tomelliot/macbook-mount/dfm/evidence/01_cartridge_front.png

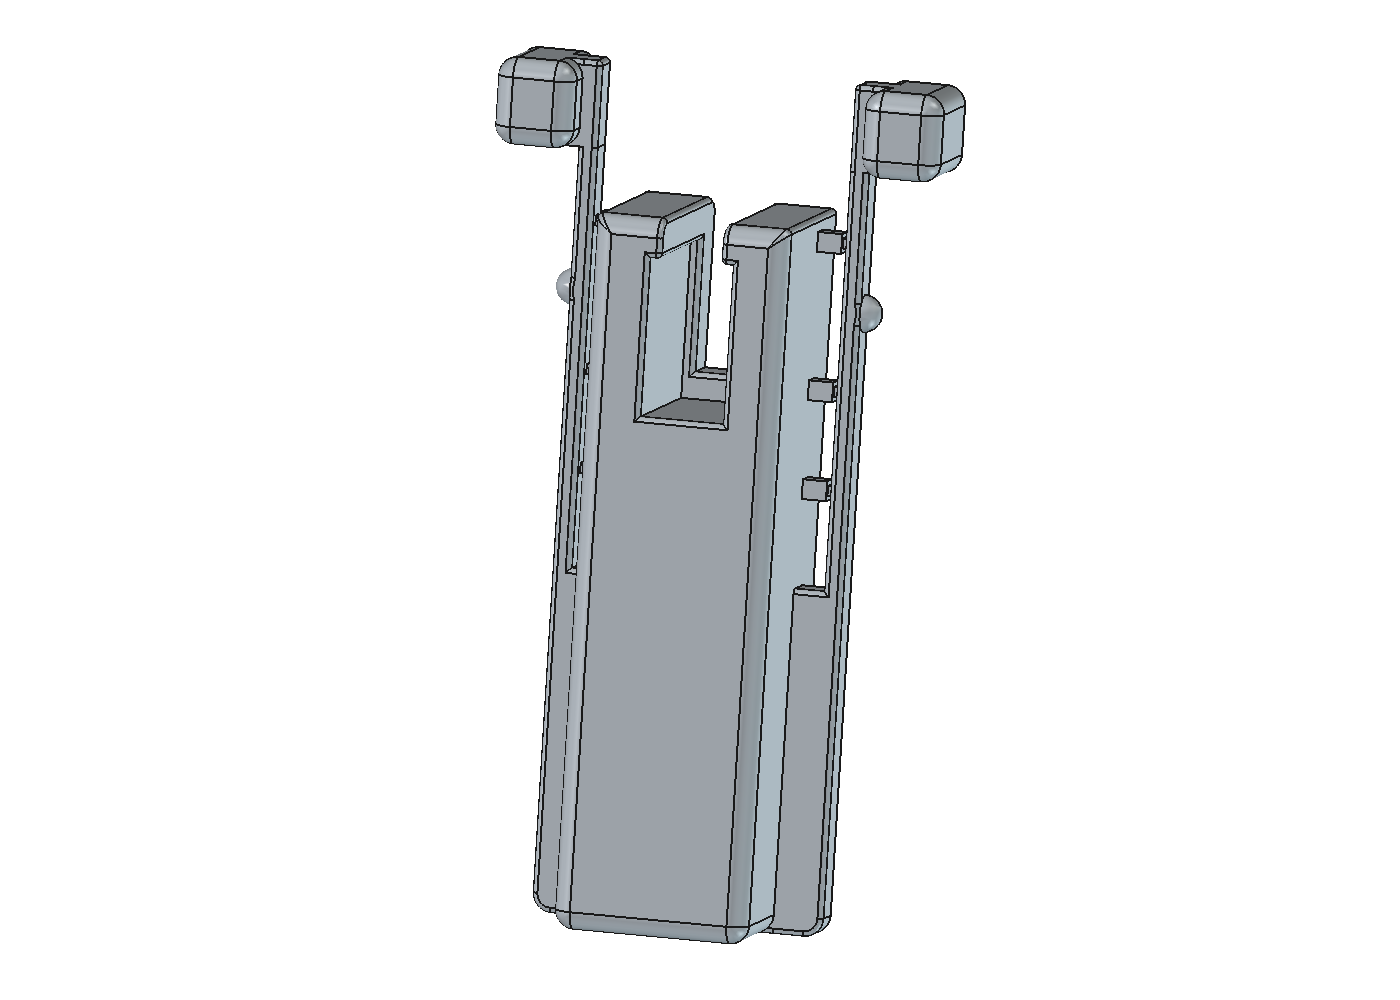
dfm/evidence/01_cartridge_front.png
