tomelliot/macbook-mount/dfm/evidence/01_cartridge_iso.png

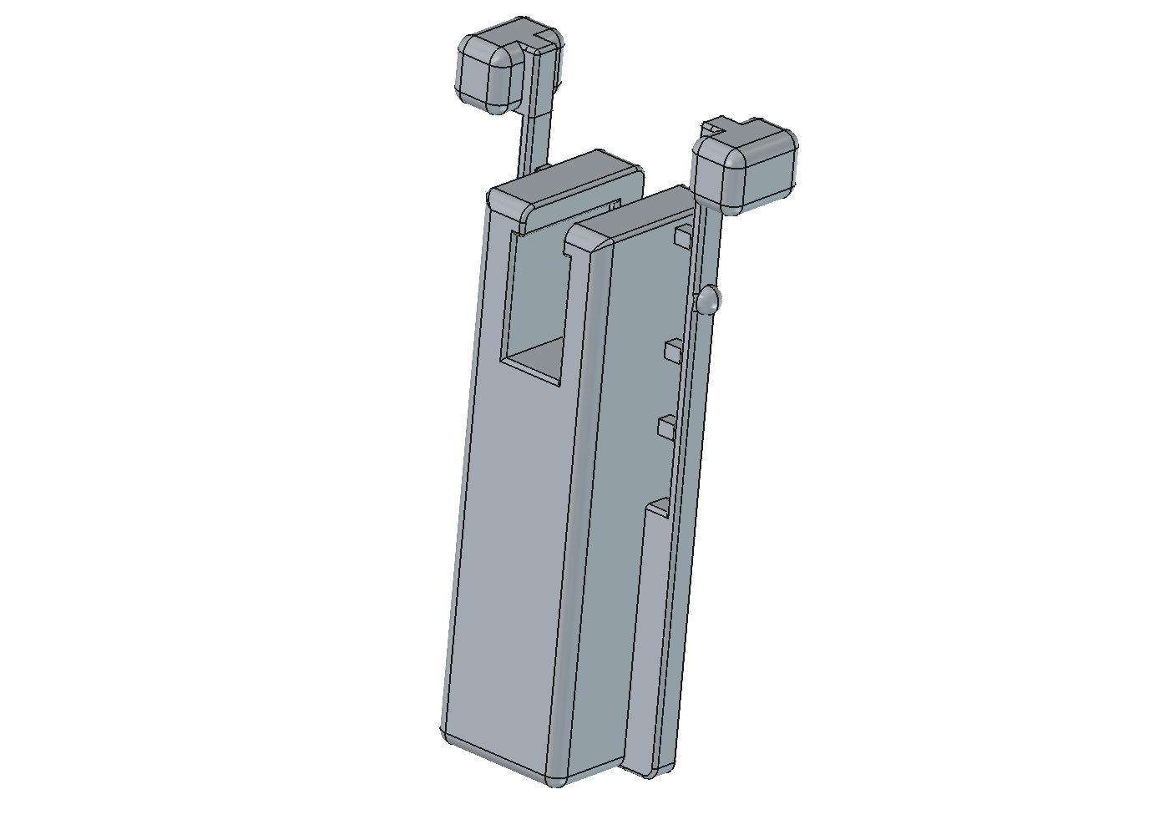
dfm/evidence/01_cartridge_iso.png
