tomelliot/macbook-mount/dfm/evidence/01_mount_back.png

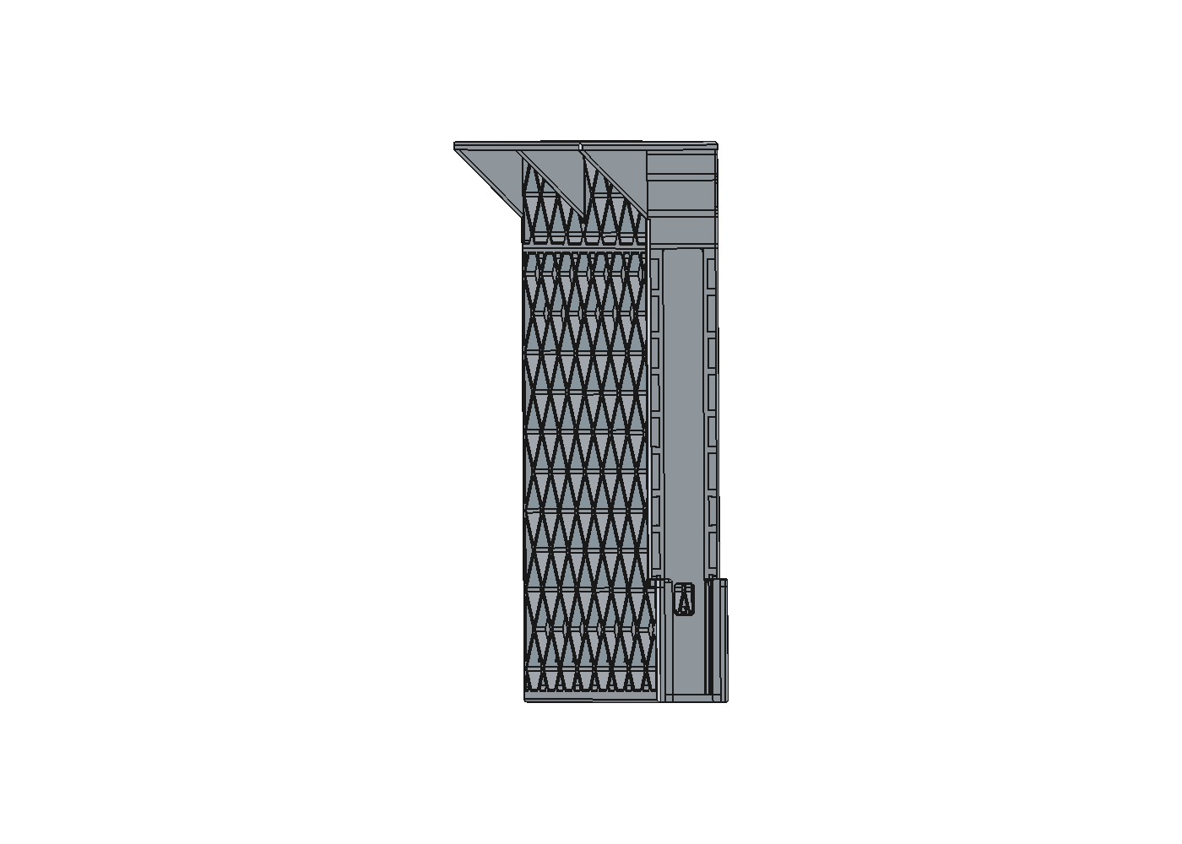
dfm/evidence/01_mount_back.png
