tomelliot/macbook-mount/dfm/evidence/01_mount_bottom.png

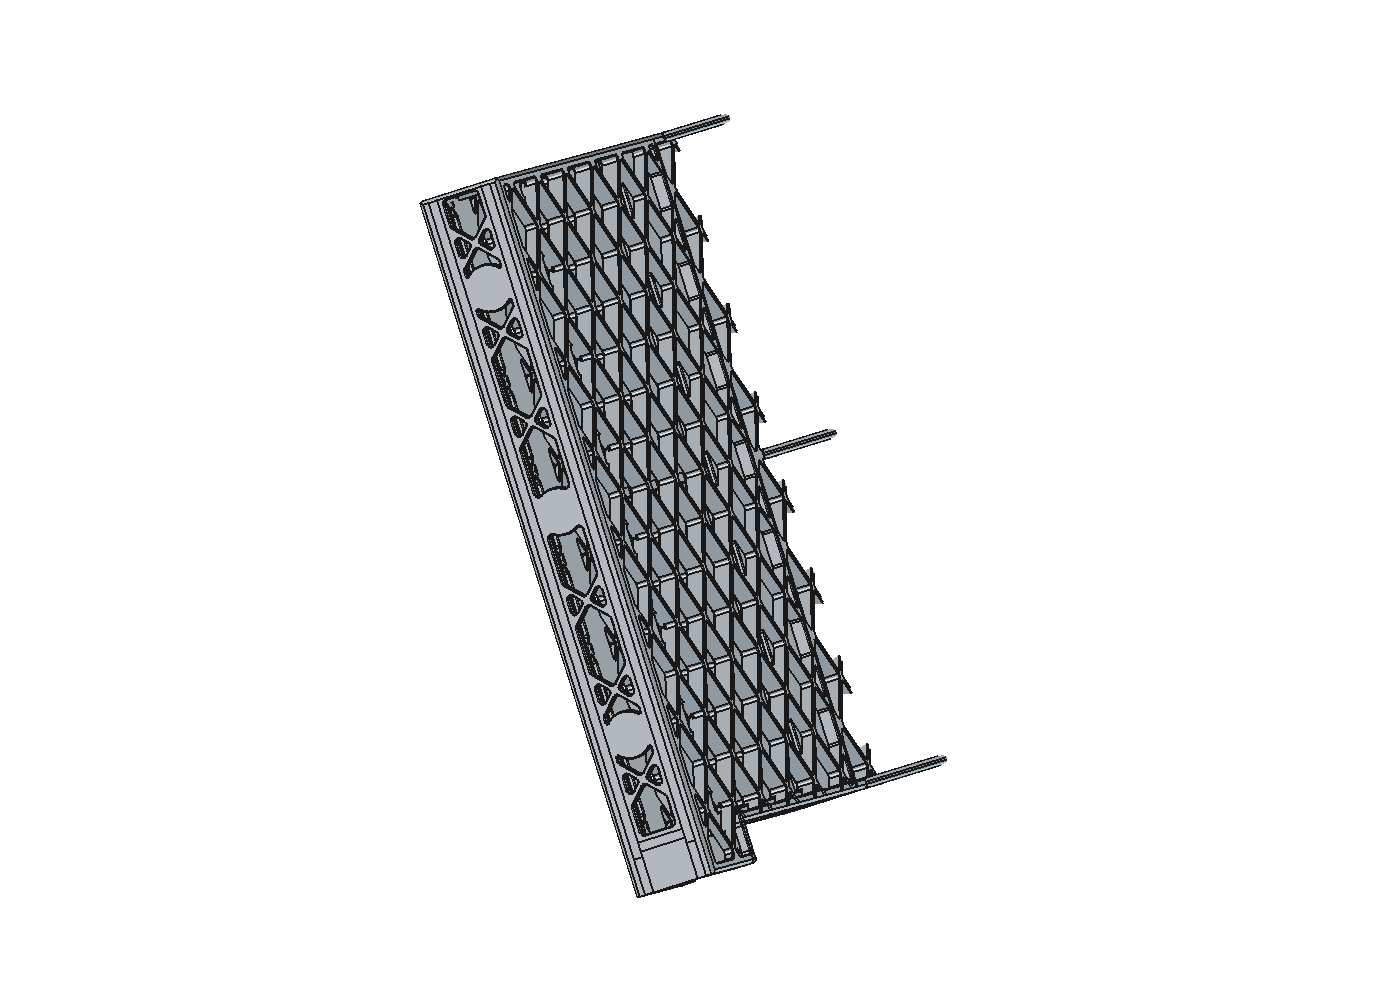
dfm/evidence/01_mount_bottom.png
