tomelliot/macbook-mount/dfm/evidence/01_mount_iso.png

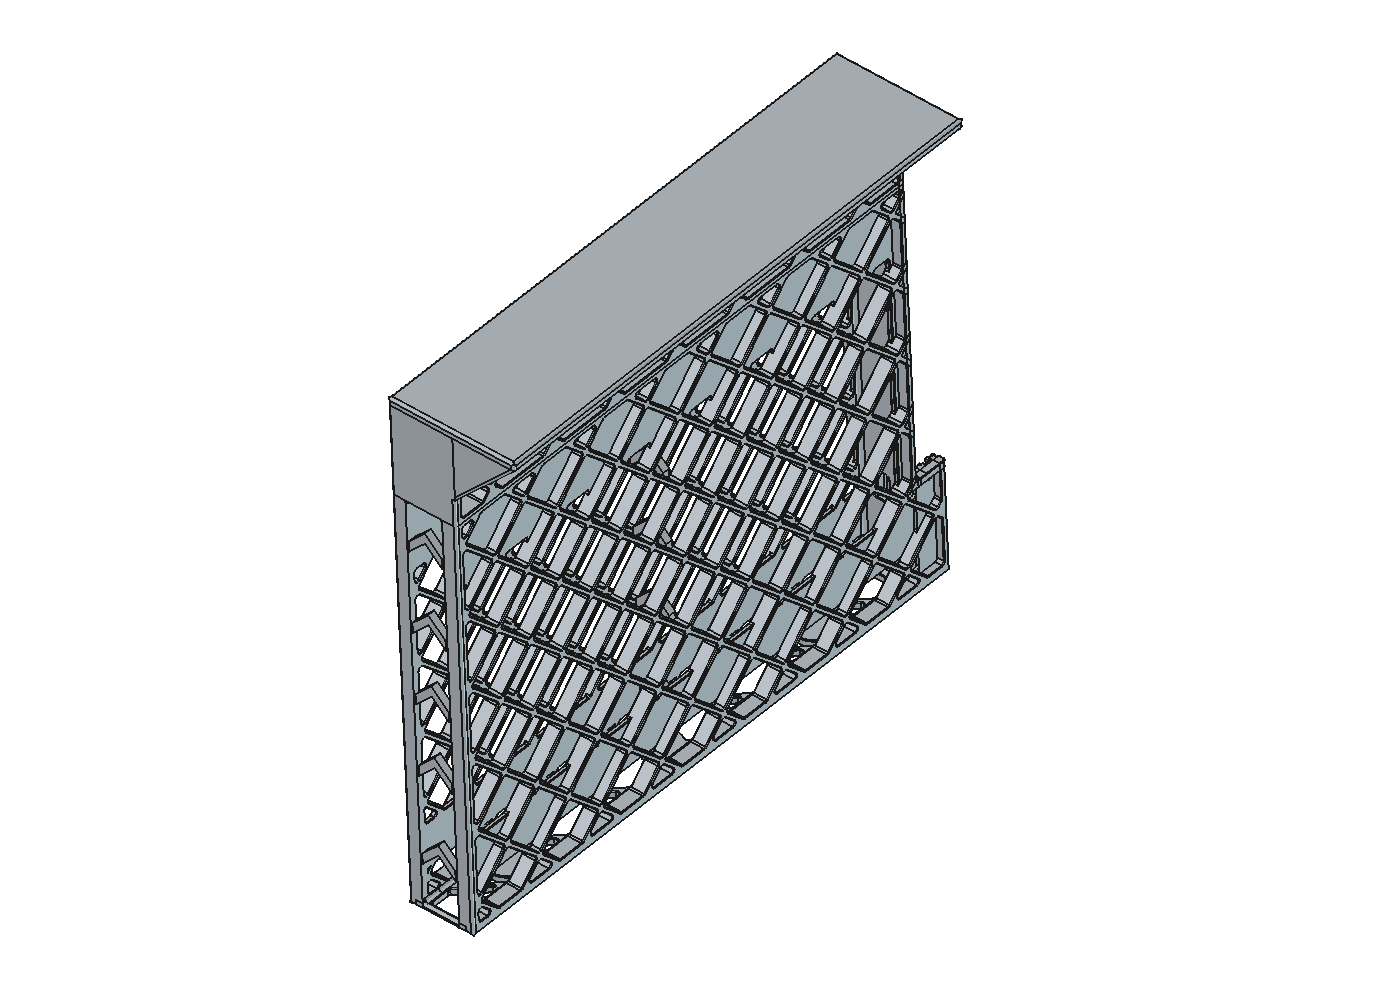
dfm/evidence/01_mount_iso.png
