tomelliot/macbook-mount/dfm/evidence/01_mount_right.png

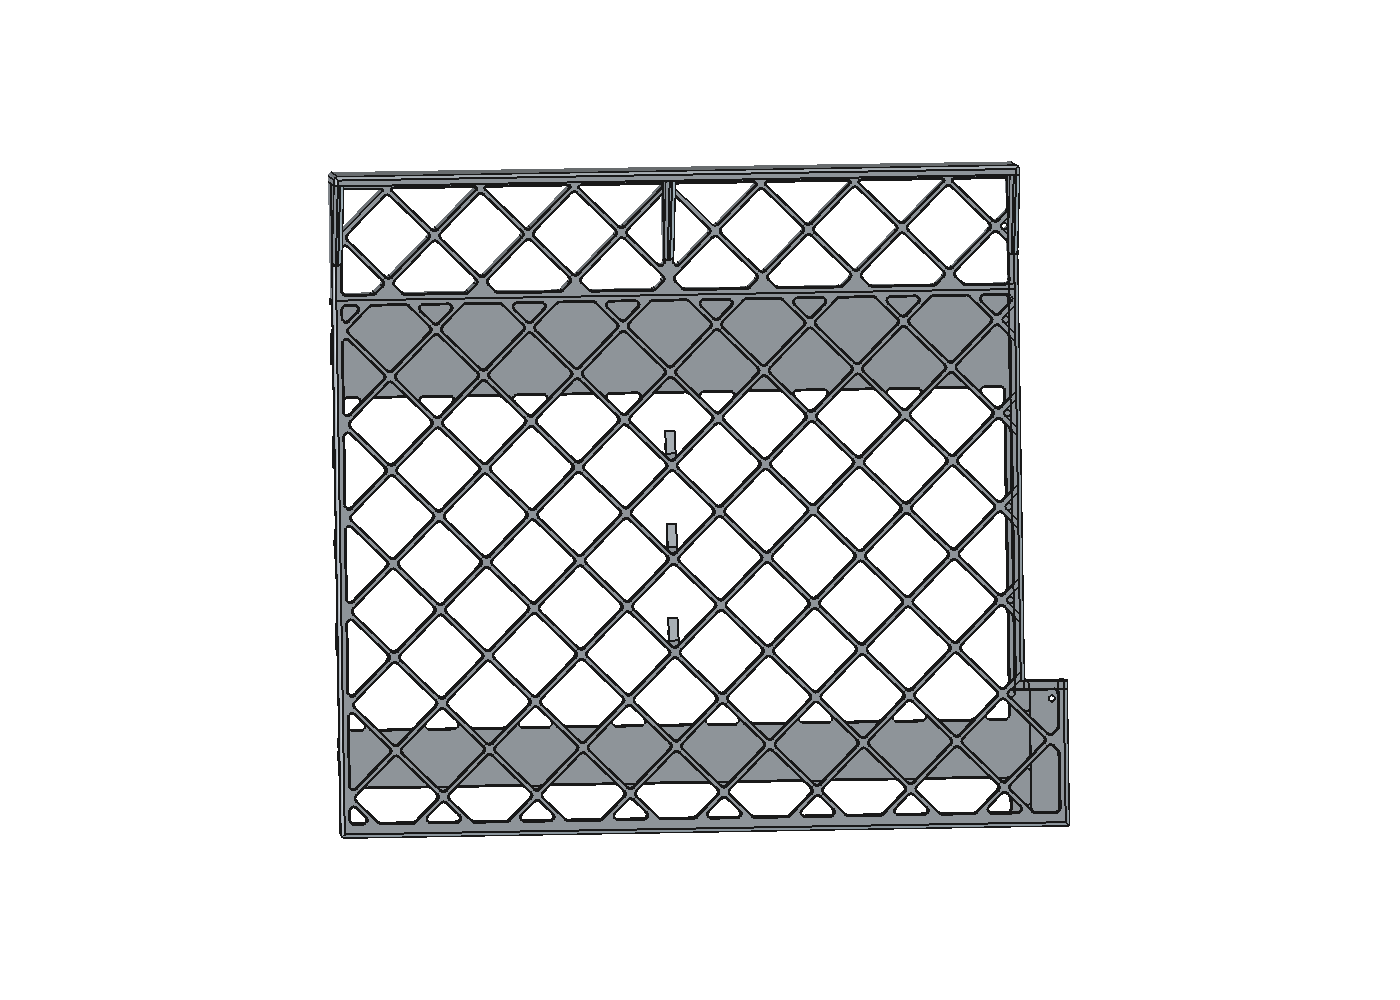
dfm/evidence/01_mount_right.png
