tomelliot/macbook-mount/dfm/evidence/02_thickness_map_cartridge.png

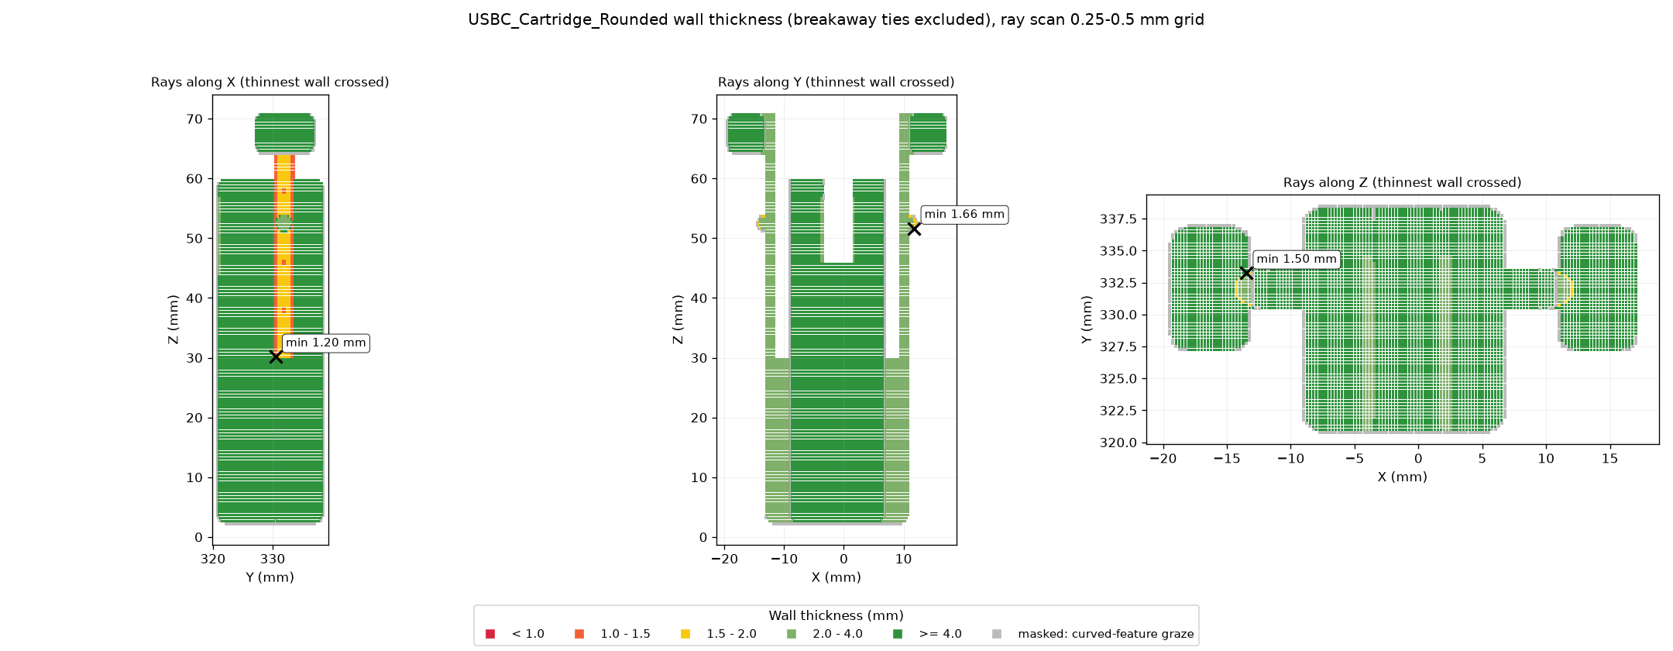
dfm/evidence/02_thickness_map_cartridge.png
