tomelliot/macbook-mount/dfm/evidence/02_thickness_map_mount.png

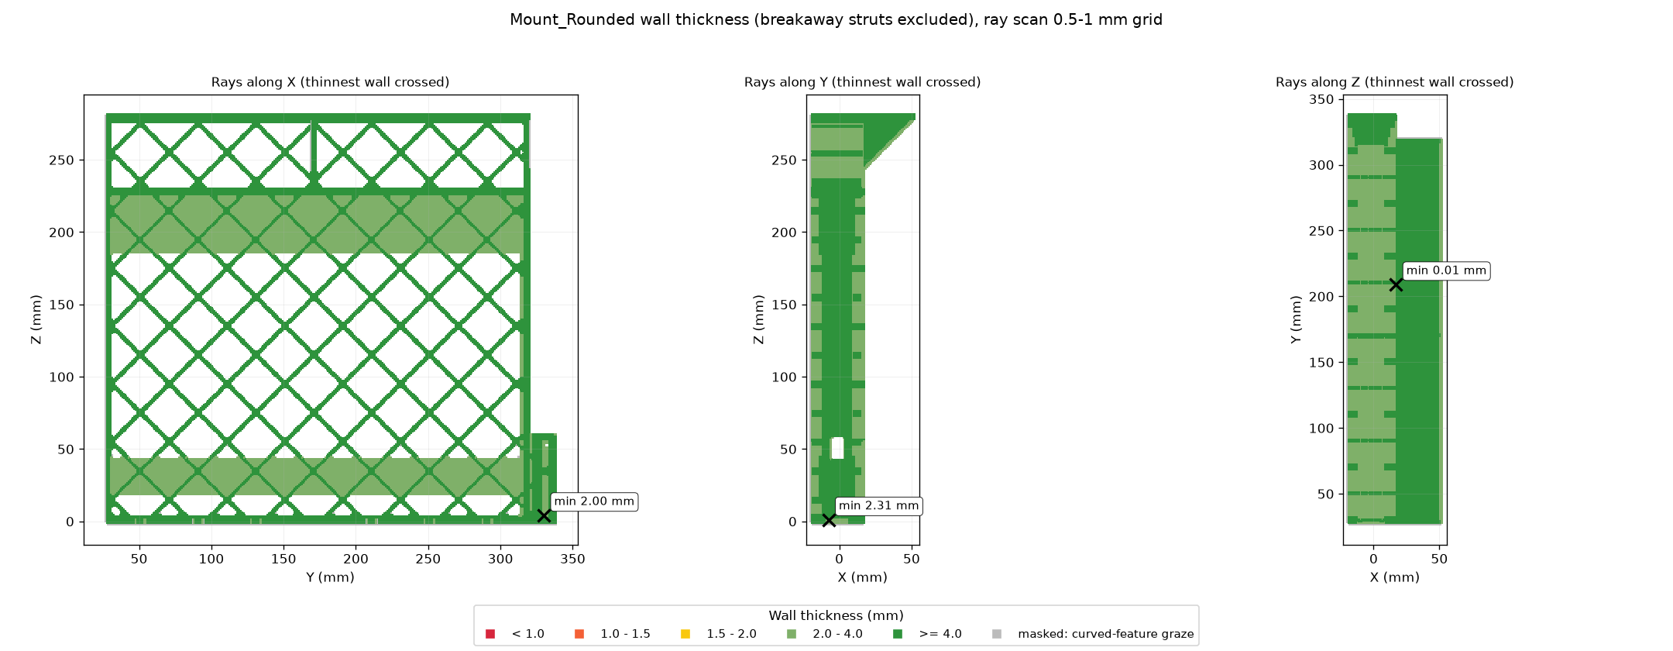
dfm/evidence/02_thickness_map_mount.png
