tomelliot/macbook-mount/dfm/evidence/05_flex_analysis.png

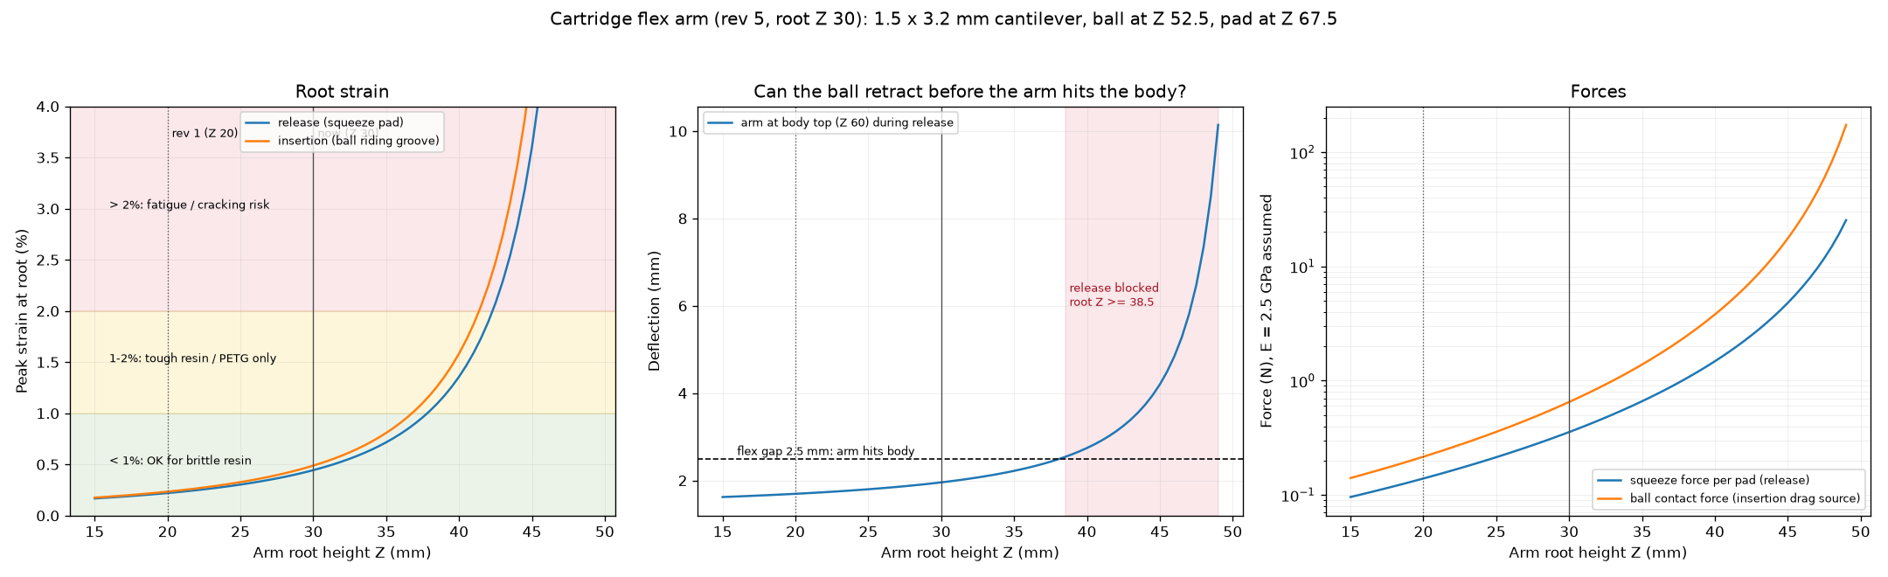
dfm/evidence/05_flex_analysis.png
