tomelliot/macbook-mount/dfm/evidence/06_clearance_bands.png

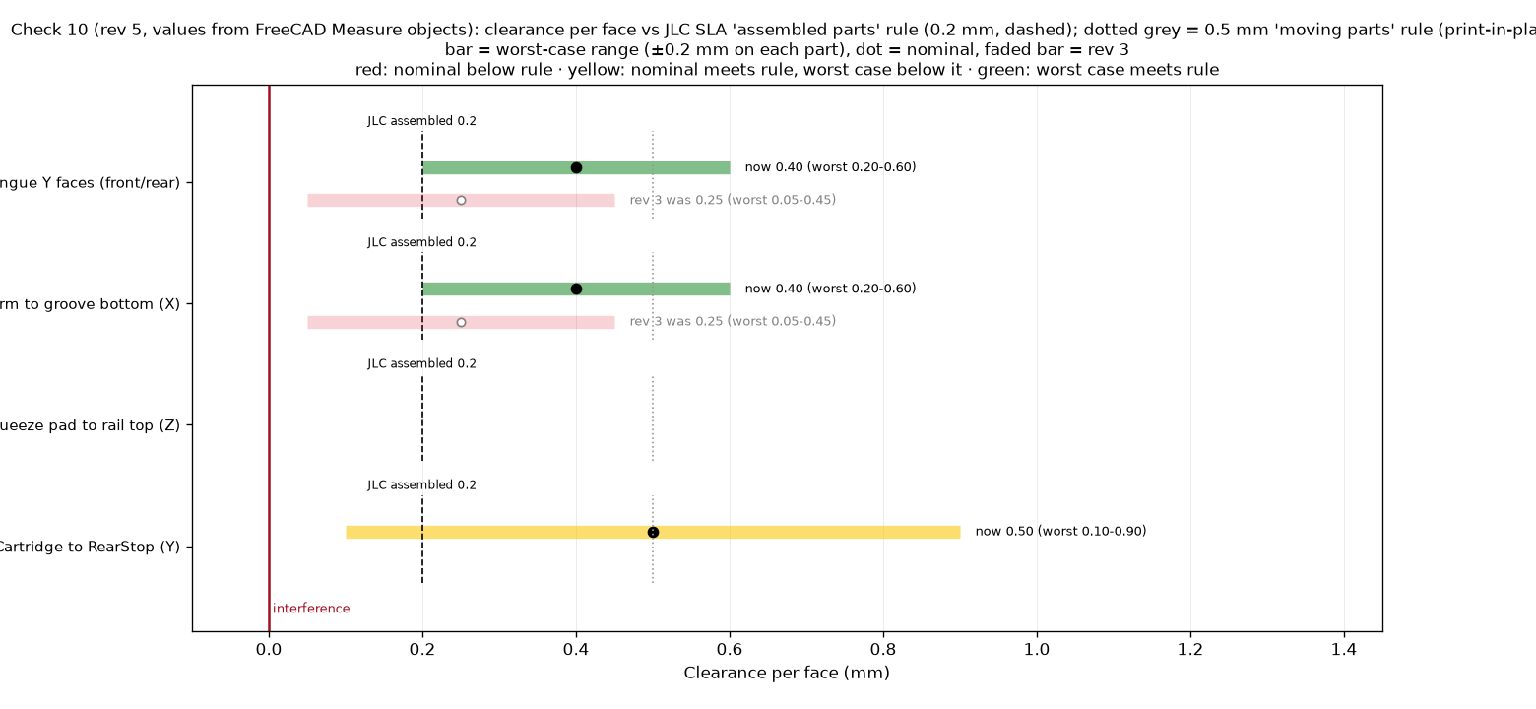
dfm/evidence/06_clearance_bands.png
