tomelliot/macbook-mount/dfm/evidence/07_breakaway_supports.png

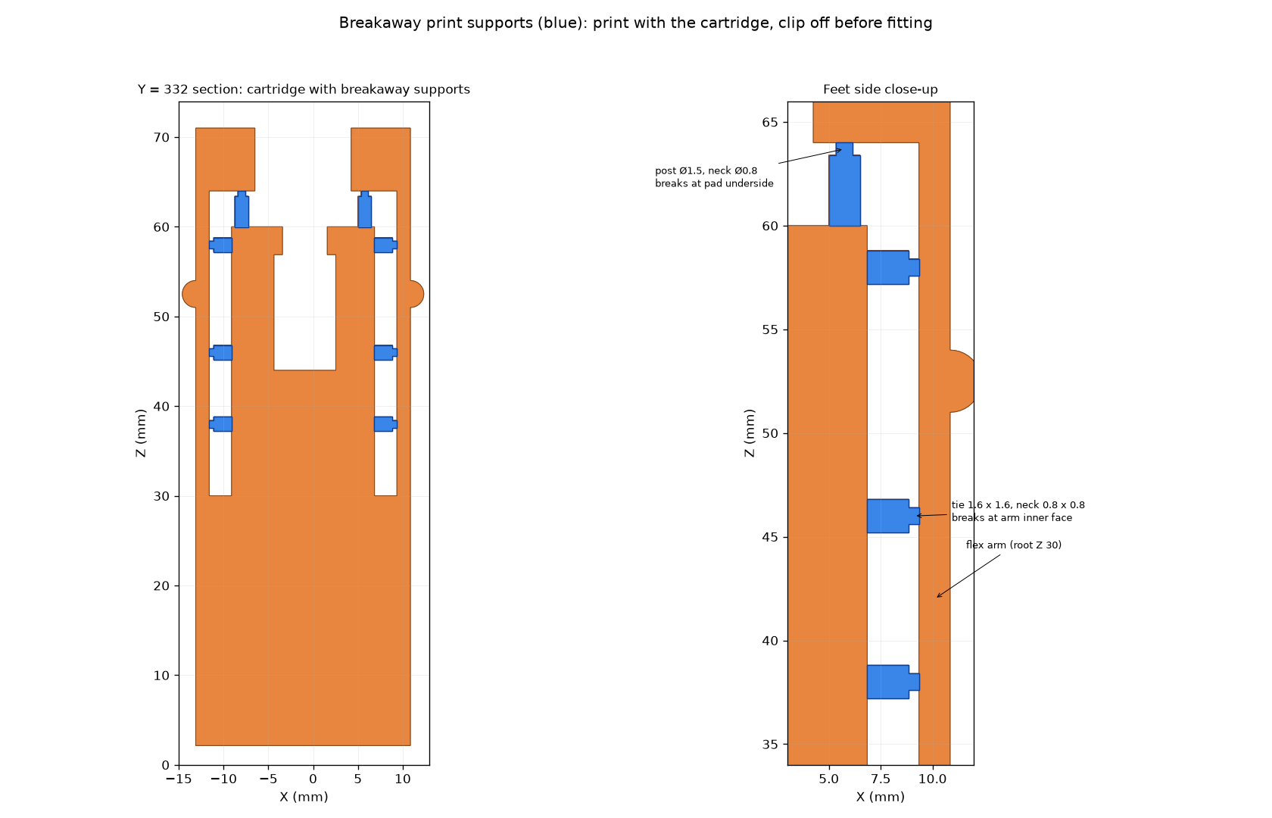
dfm/evidence/07_breakaway_supports.png
