tomelliot/macbook-mount/dfm/evidence/08_support_map.png

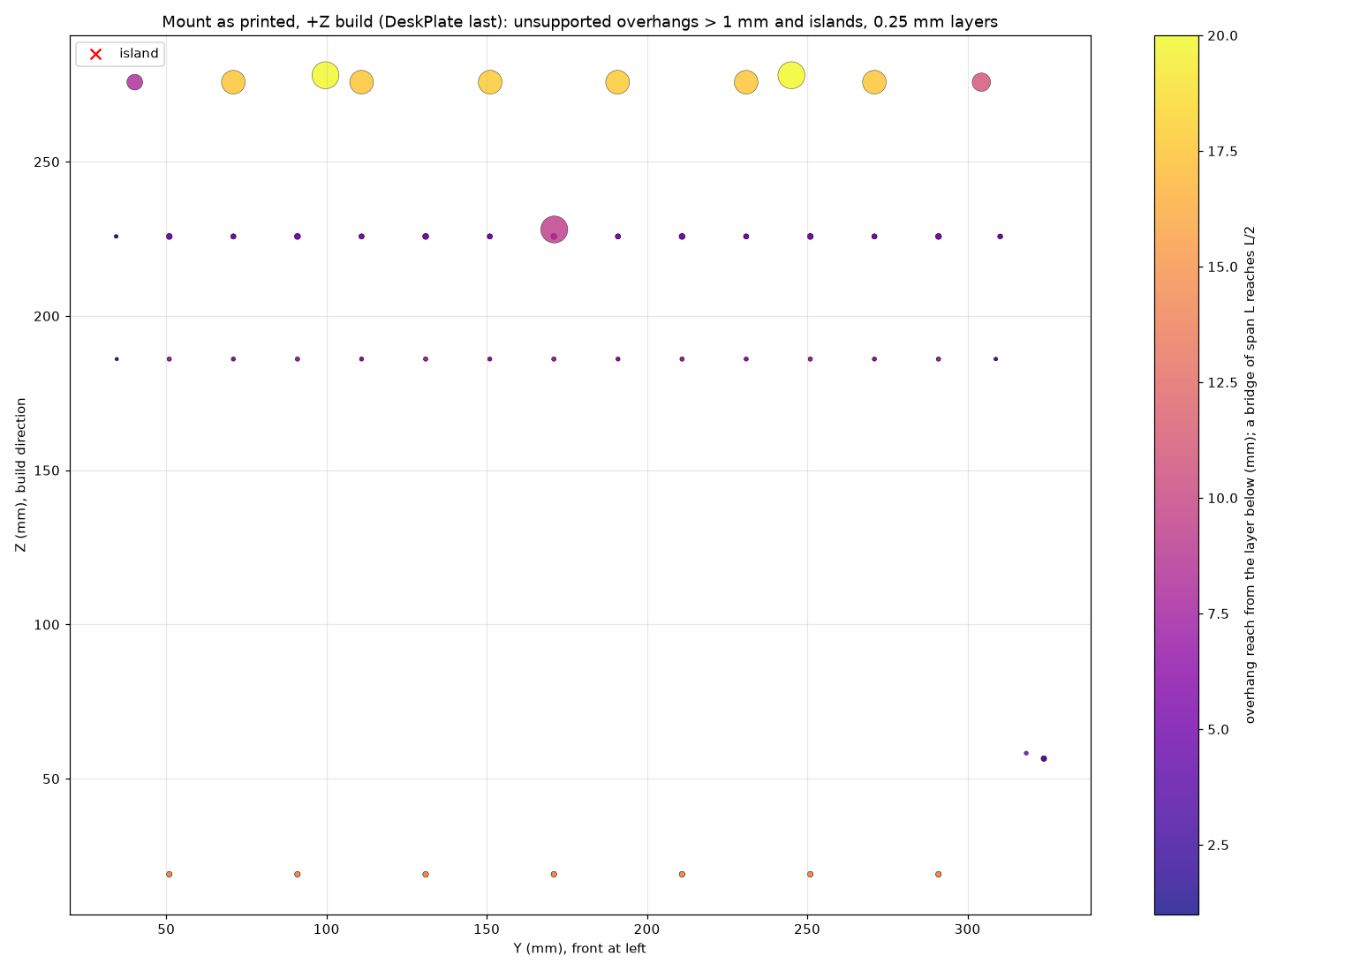
dfm/evidence/08_support_map.png
