tomelliot/macbook-mount/DeskMount.FCStd

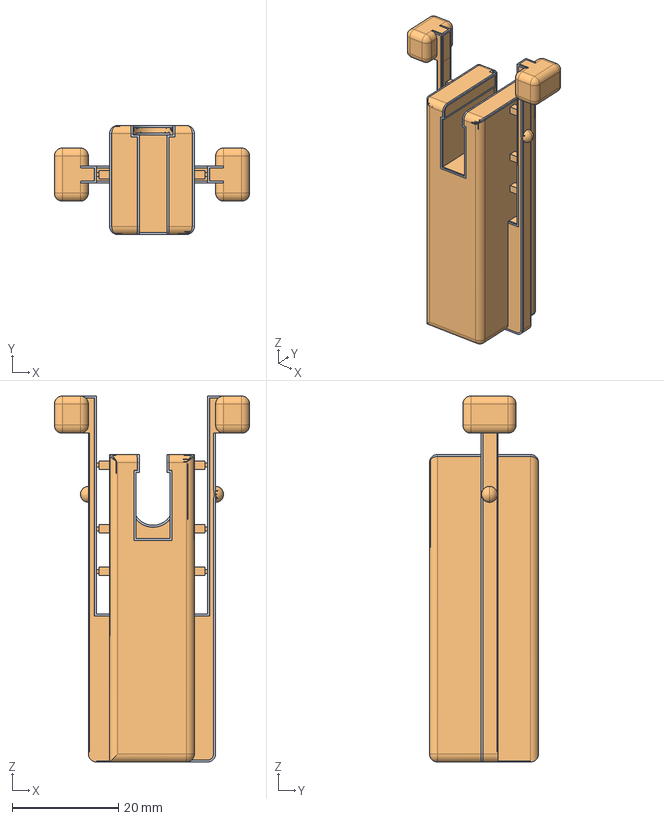
[picture p13: CAD file, 2026-10-14]
DeskMount.FCStd
36.7 x 20.5 x 68.8 mm
USBC_Cartridge_D
USBC_Cartridge_C
USBC_Cartridge_C2
USBC_Cartridge_E_Cutters
