tomelliot/macbook-mount/export/DeskMount_mount.step

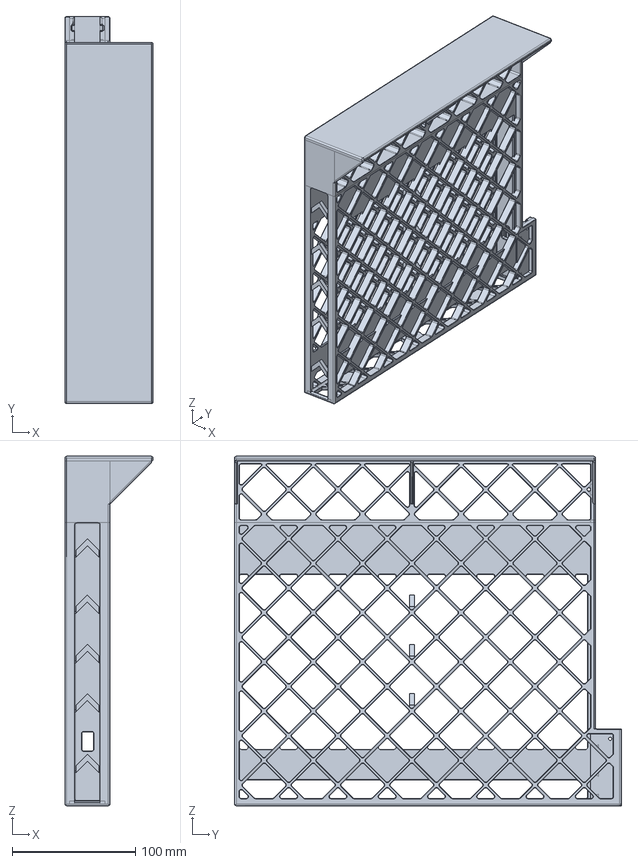
[picture p14: CAD file, 2026-10-14]
export/DeskMount_mount.step
71.7 x 314.2 x 283.9 mm
