tomelliot/macbook-mount/reference/MacBookPro Desk Mount 14 (original reference).stl

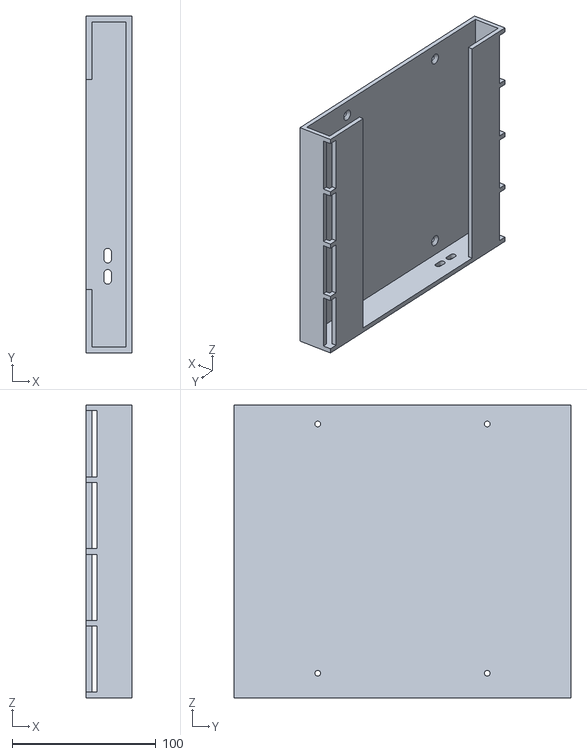
[picture p15: CAD file, 2026-10-07]
reference/MacBookPro Desk Mount 14 (original reference).stl
31.9 x 234.5 x 204.0
