tomelliot/macbook-mount/export/DeskMount_usbc_cartridge.step

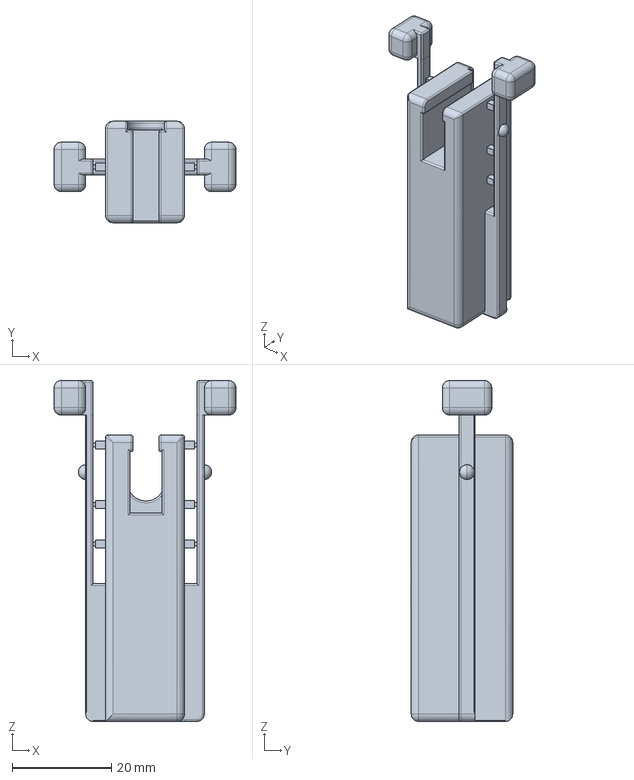
[picture p16: CAD file, 2026-10-14]
export/DeskMount_usbc_cartridge.step
36.7 x 20.5 x 68.8 mm
