tomelliot/macbook-mount/dfm/evidence/01_assembly_iso.png

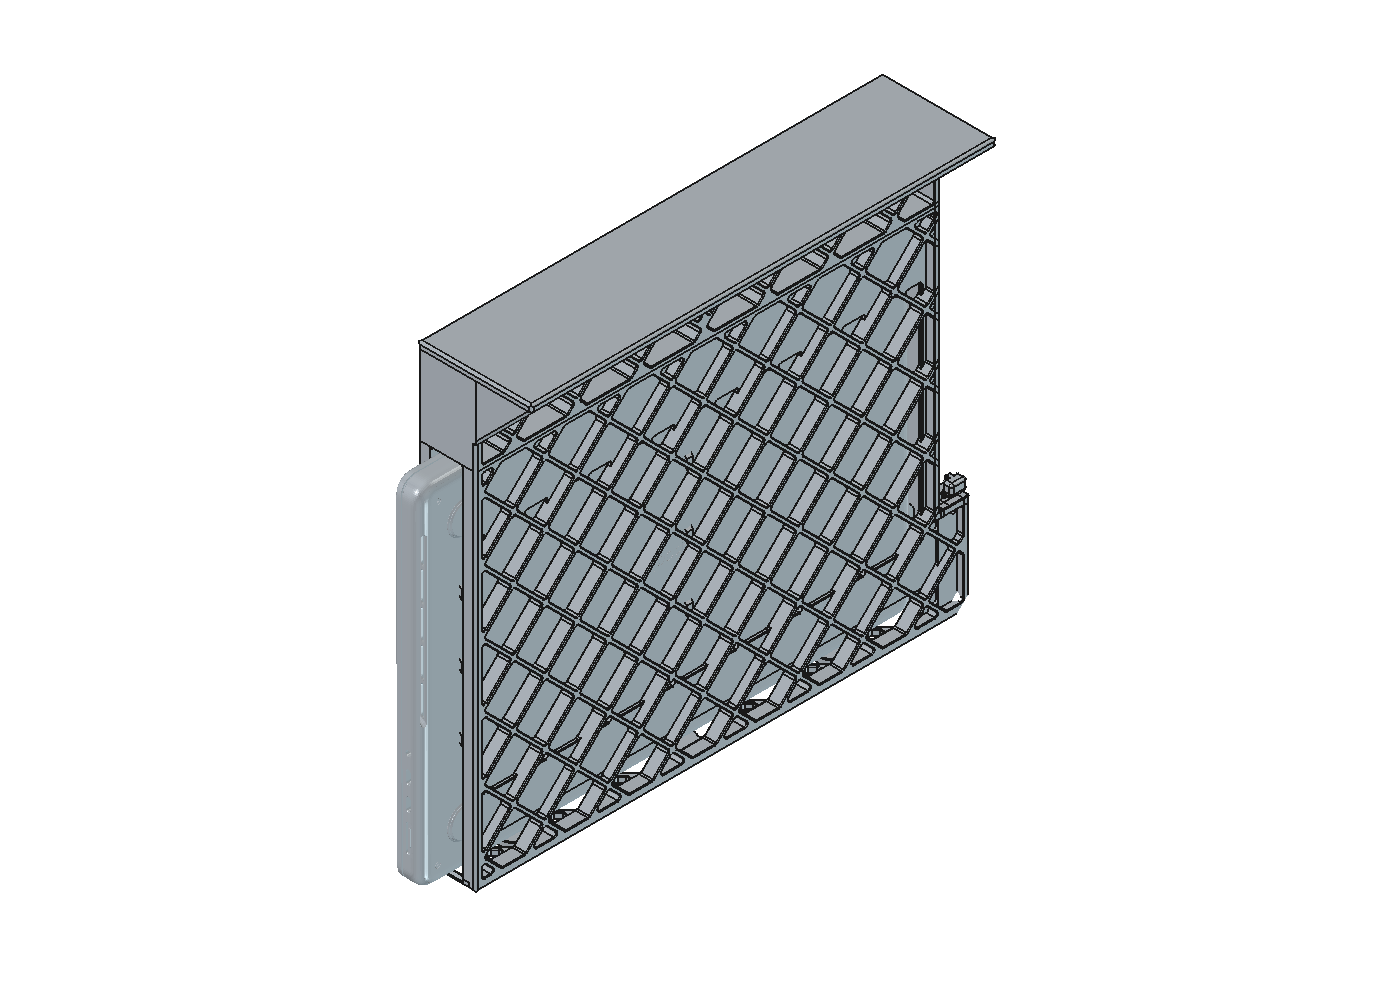
dfm/evidence/01_assembly_iso.png
