tomelliot/macbook-mount/dfm/evidence/03_clearance_sections.pdf

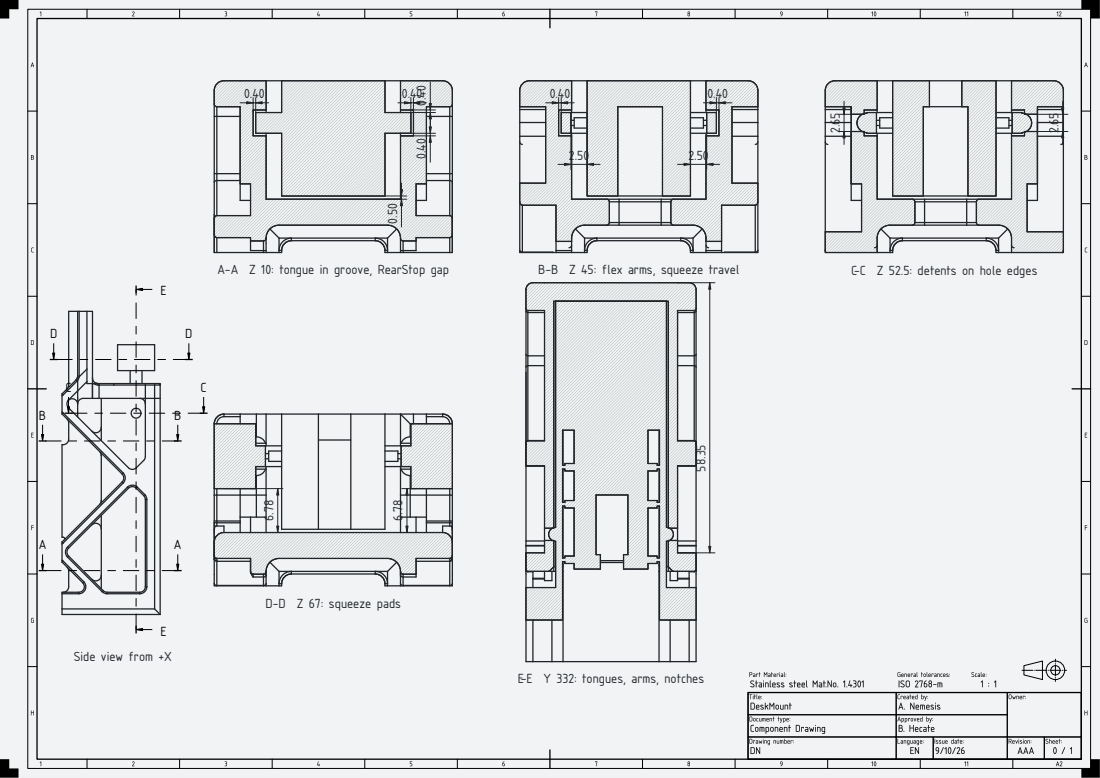
[picture p18: page 1]
D-D Z 67: squeeze pads

A-A Z 10: tongue in groove, RearStop gap

B-B Z 45: flex arms, squeeze travel

C-C Z 52.5: detents on hole edges

Side view from +X

E-E Y 332: tongues, arms, notches
