tomelliot/macbook-mount/dfm/evidence/09_mount_structure.pdf

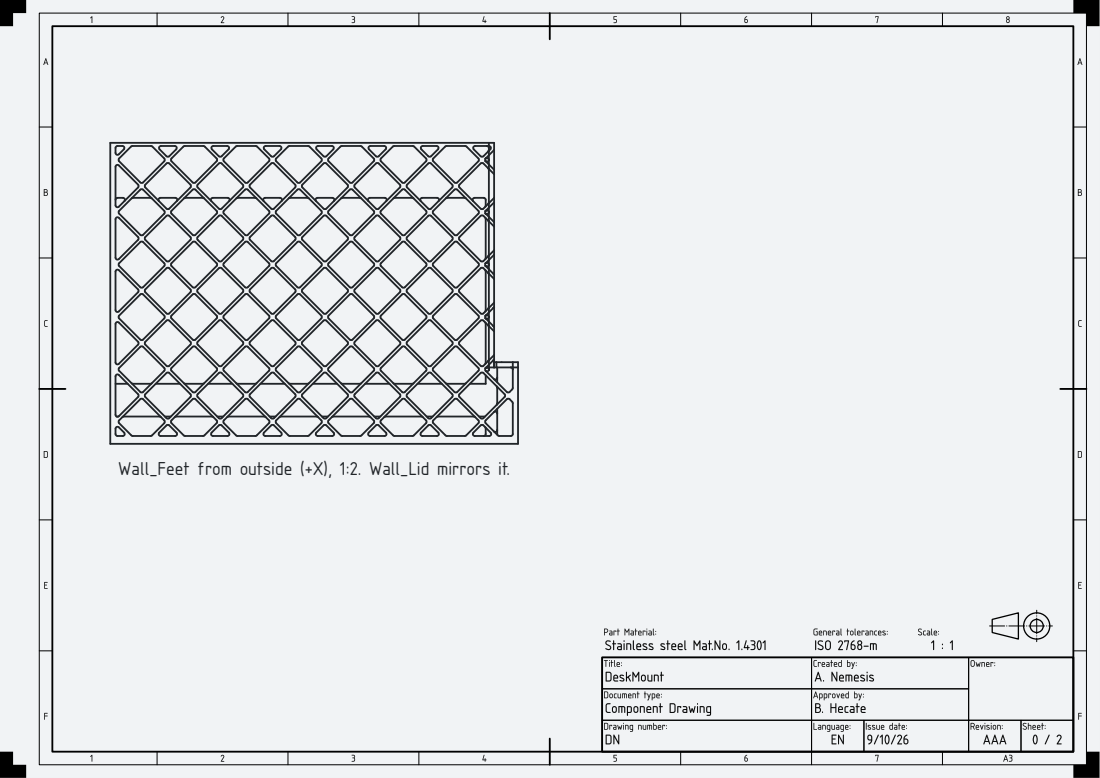
[picture p19: page 1]

Wall_Feet from outside (+X), 1:2. Wall_Lid mirrors it.
