tomelliot/macbook-mount/(commit log)

2026-10-07 Add MacBook Pro 14 under-desk mount design
    FreeCAD model, STEP exports for JLC3DP, the SLA DFM checklist with
    evidence and scripts, the design journal, and a design summary.
    [DeskMount.FCStd, DeskMount_mount.step, DeskMount_usbc_cartridge.step, MacBookPro Desk Mount 14 (original reference).stl]
2026-10-13 Checkpoint before reorganising: grid floor, struts, print bodies, DFM rev 6
    Design state before the project and model cleanup: grid floor with felt
    discs, Lambda breakaway struts, rounded print bodies, build pipeline in
    build/, in-model fillets for the simple parts, DFM report rev 6 with
    regenerated evidence, skin fix and pocket-notch fill in the source walls
    (print bodies not yet rebuilt for those), and the 27 backup objects still
    in the model.
    [DeskMount.FCStd, DeskMount_mount.step, DeskMount_usbc_cartridge.step]
2026-10-14 Reorganise build and DFM scripts; laptop flush to RearStop
    - Move the rounding and fuse scripts to cad/. Mount_Rounded is a live
    feature (cad/mount_fuse.py) with inside-corner fills and edge cutters.
    - Collapse the DFM scripts into fc_headless.py, fc_gui.py, mesh_scans.py,
    calcs.py and plots.py, run by dfm/run_dfm.sh.
    - Fix the DFM fit check, which added the laptop placement twice.
    - Gussets 2.4 mm; cartridge rails extended to RearStop's face.
    - Laptop sits flush against RearStop. Cartridge pocket sized for a
    23 x 12 x 6 mm overmold, rear wall at Y 339.425 (1.8 mm), 5.2 mm top
    cutout and 7.5 mm R3.75 cable exit.
    - RearStop face rounds reduced from R2 to R0.5.
    - Rename DESIGN.md to RE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
    [DeskMount.FCStd, DeskMount_mount.step, DeskMount_usbc_cartridge.step]
